ryood/ArEG/2nd Unit/PXL_20220523_073205050.jpg

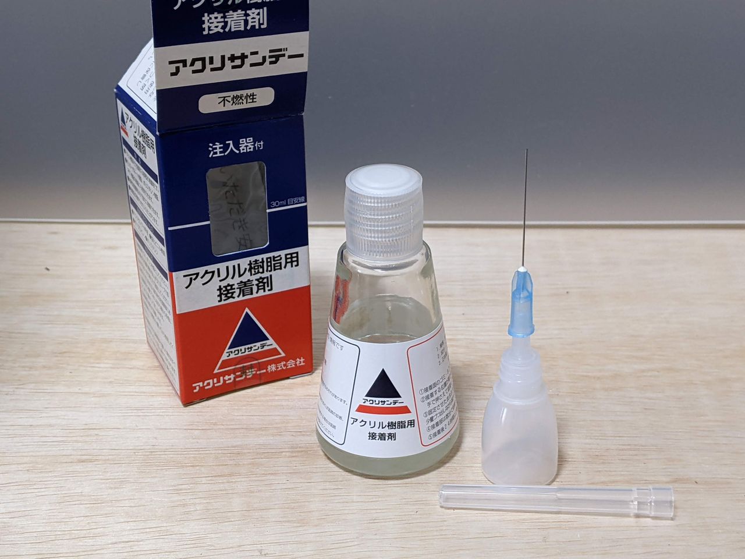
2nd Unit/PXL_20220523_073205050.jpg
