ryood/ArEG/2nd Unit/PXL_20220523_032654359.jpg

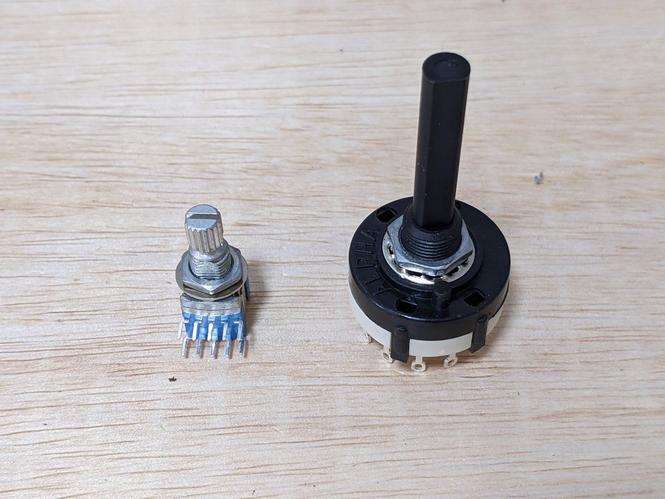
2nd Unit/PXL_20220523_032654359.jpg
