ryood/ArEG/2nd Unit/20220430_043404.png

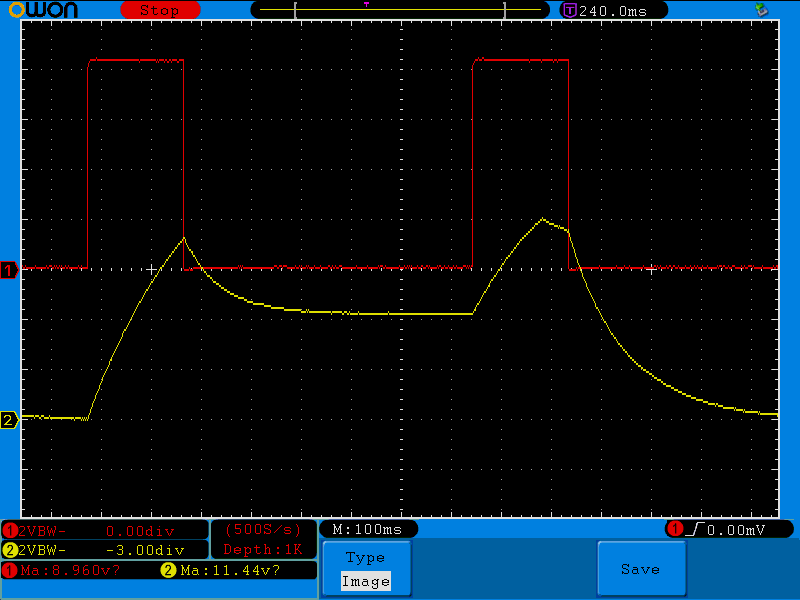
2nd Unit/20220430_043404.png
