ryood/ArEG/2nd Unit/20220502_182553.png

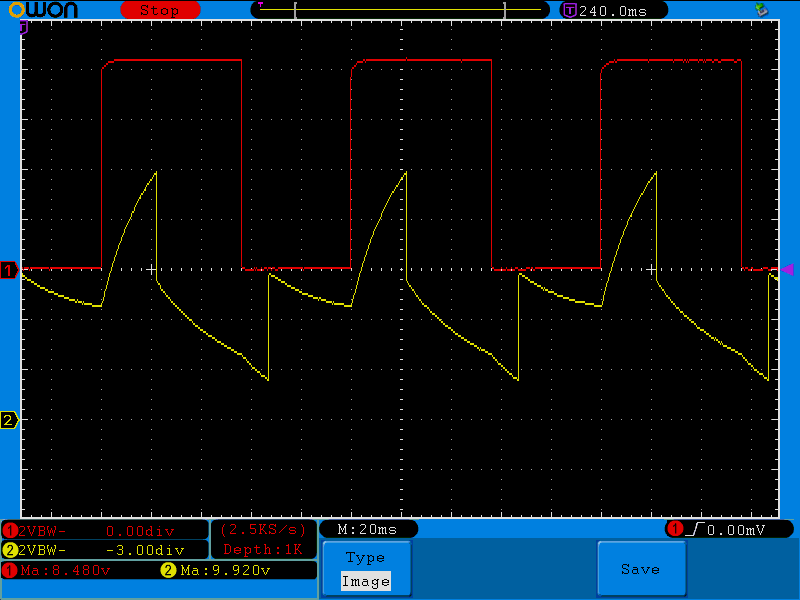
2nd Unit/20220502_182553.png
