ryood/ArEG/2nd Unit/PXL_20220523_032018060.jpg

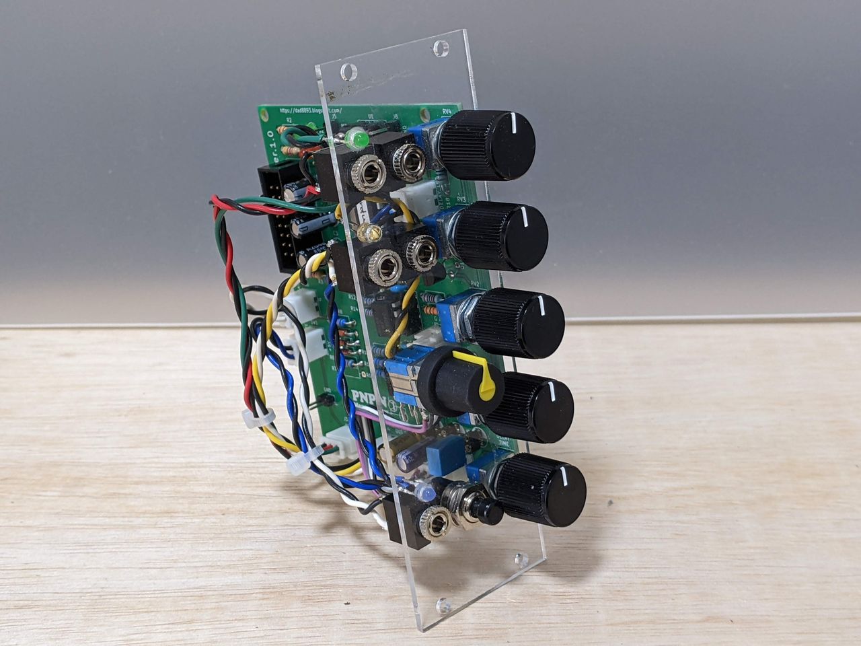
2nd Unit/PXL_20220523_032018060.jpg
