ryood/ArEG/KiCAD/ArEG_Brd3D.png

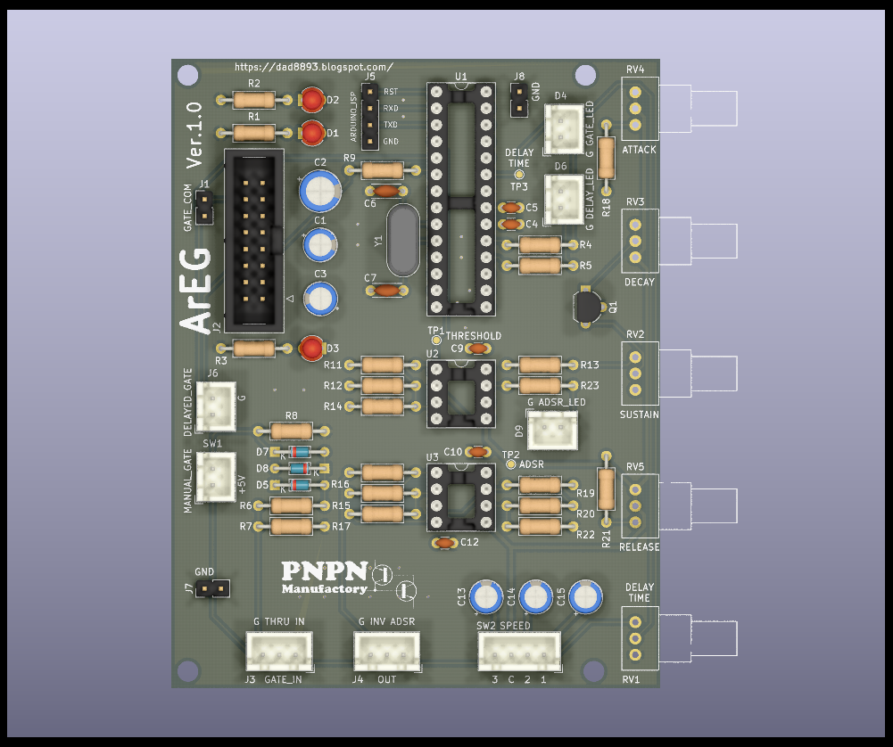
KiCAD/ArEG_Brd3D.png
