ryood/ArEG/KiCAD/ArEG_Brd3D_0.png

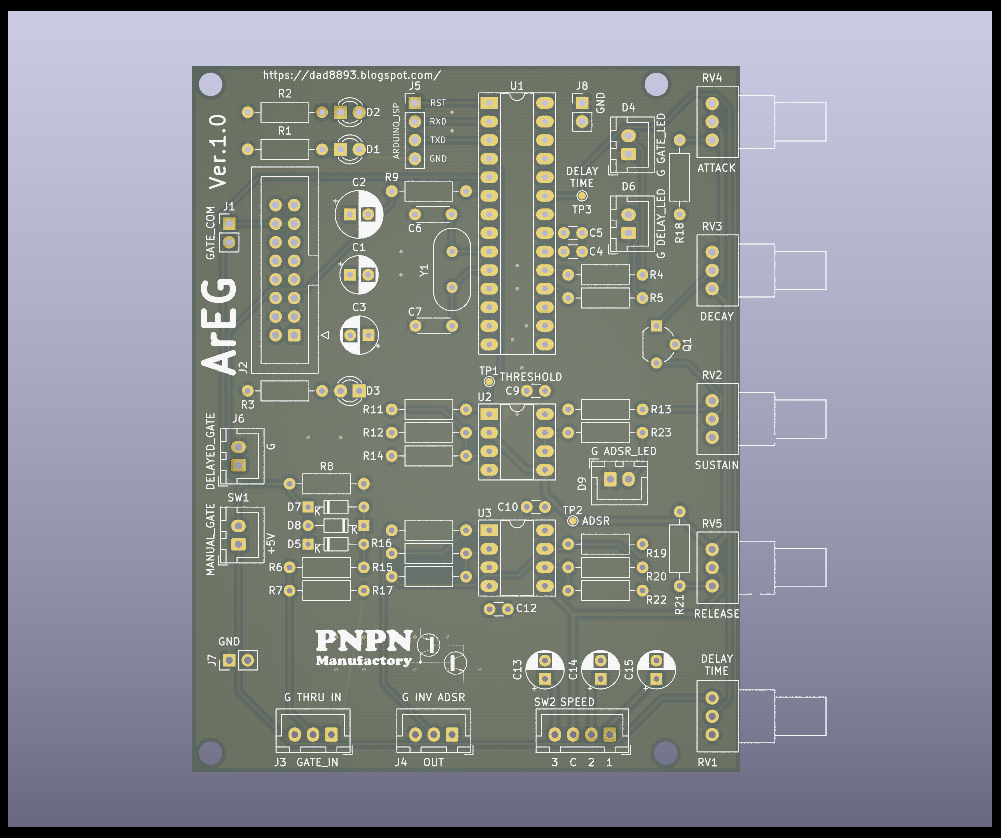
KiCAD/ArEG_Brd3D_0.png
