ryood/ArEG/KiCAD/ArEG_sch.png

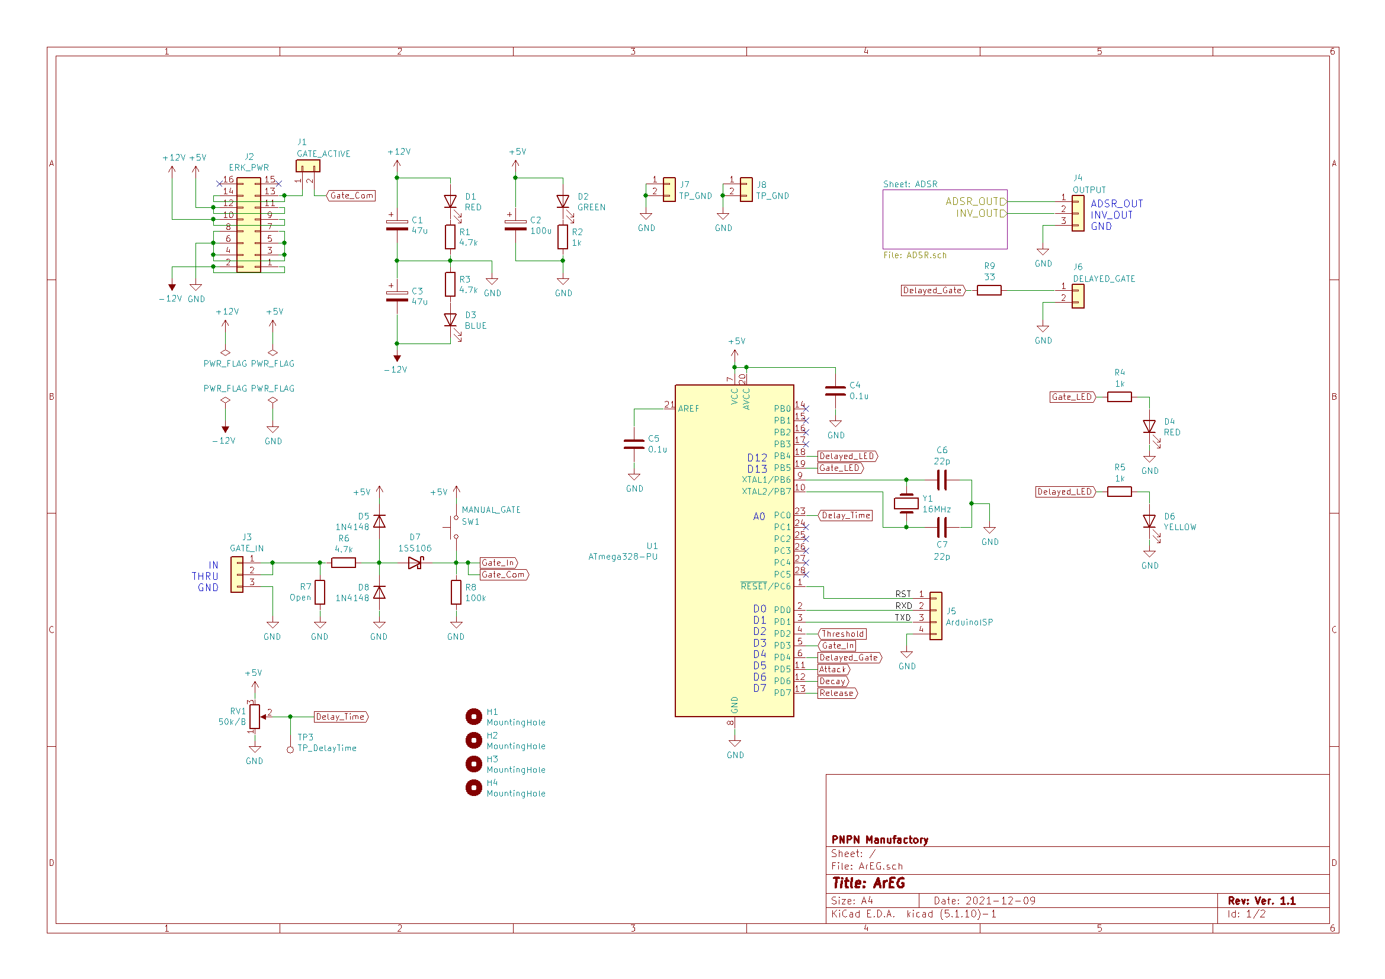
KiCAD/ArEG_sch.png
