ryood/ArEG/KiCAD/ArEG_sch_02.png

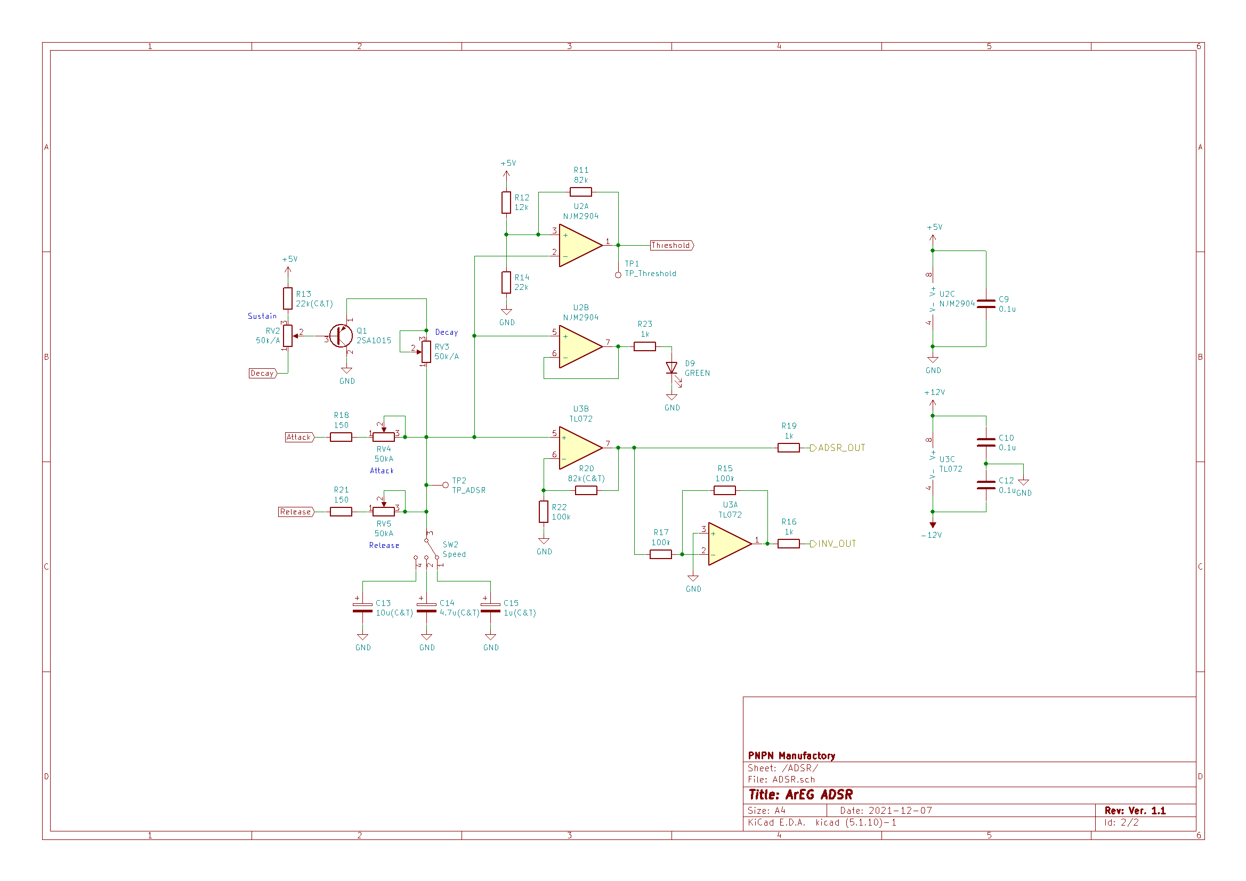
KiCAD/ArEG_sch_02.png
