ryood/ArEG/spice/ADSR+Inv_Hys_Comparetor_sim.png

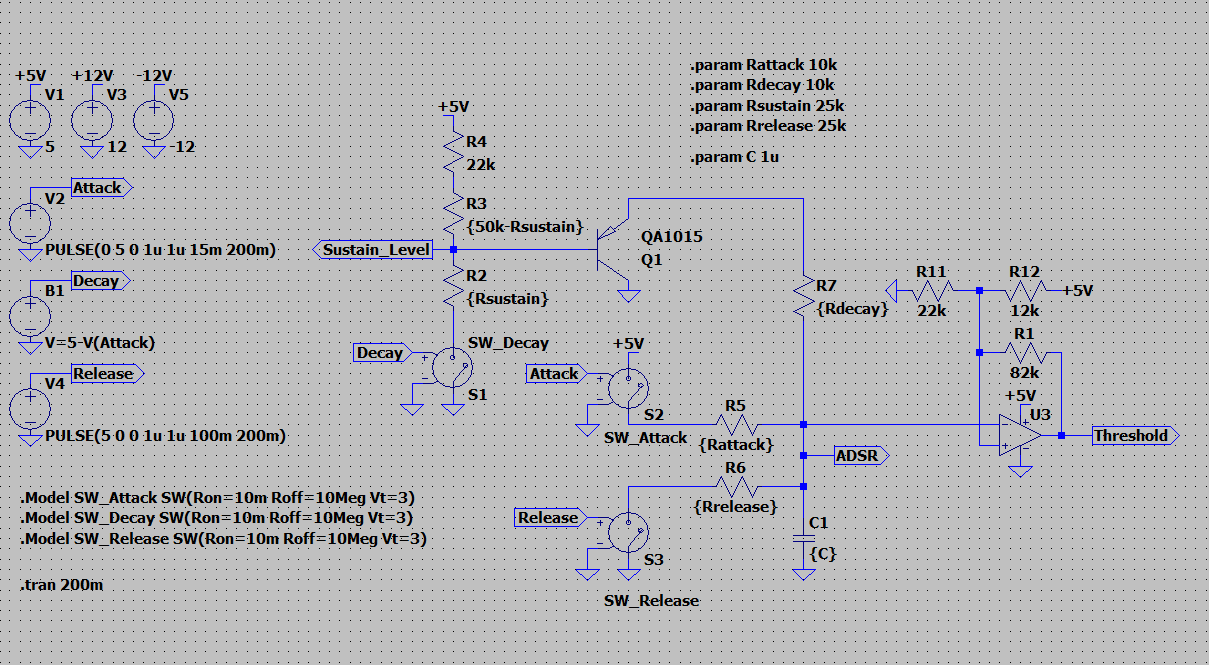
spice/ADSR+Inv_Hys_Comparetor_sim.png
