ryood/ArEG/spice/ADSR+Inv_Hys_Comparetor_tran.png

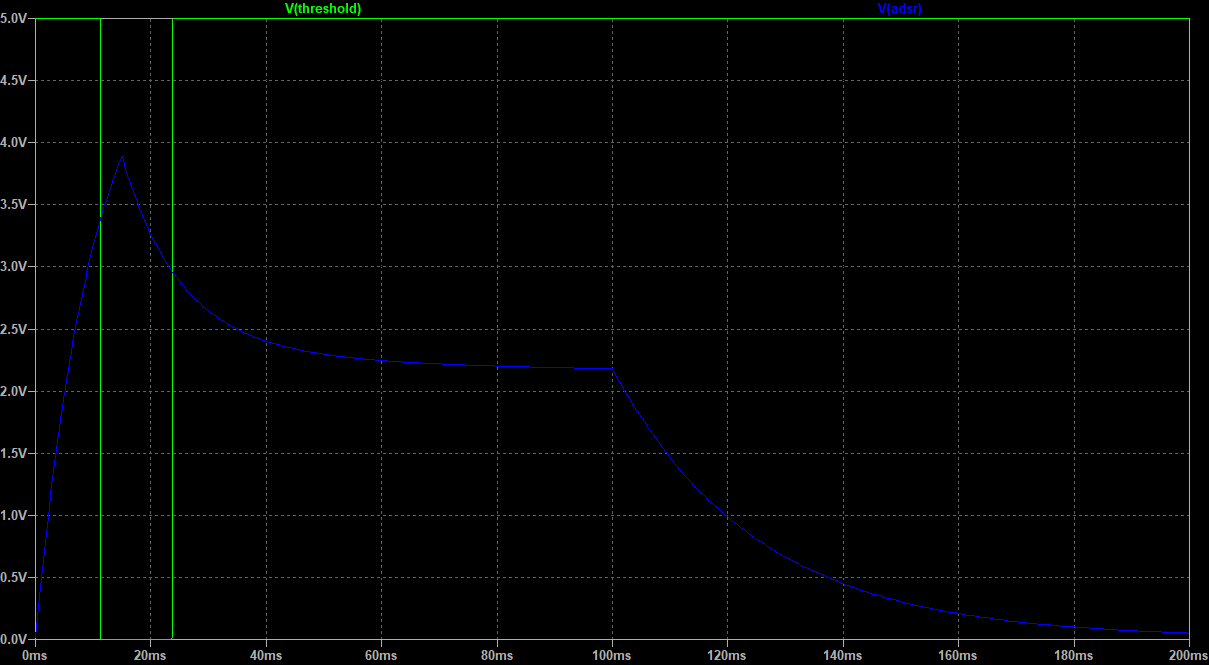
spice/ADSR+Inv_Hys_Comparetor_tran.png
