ryood/ArEG/spice/ADSR+NonInv_Hys_Comparetor_sim.png

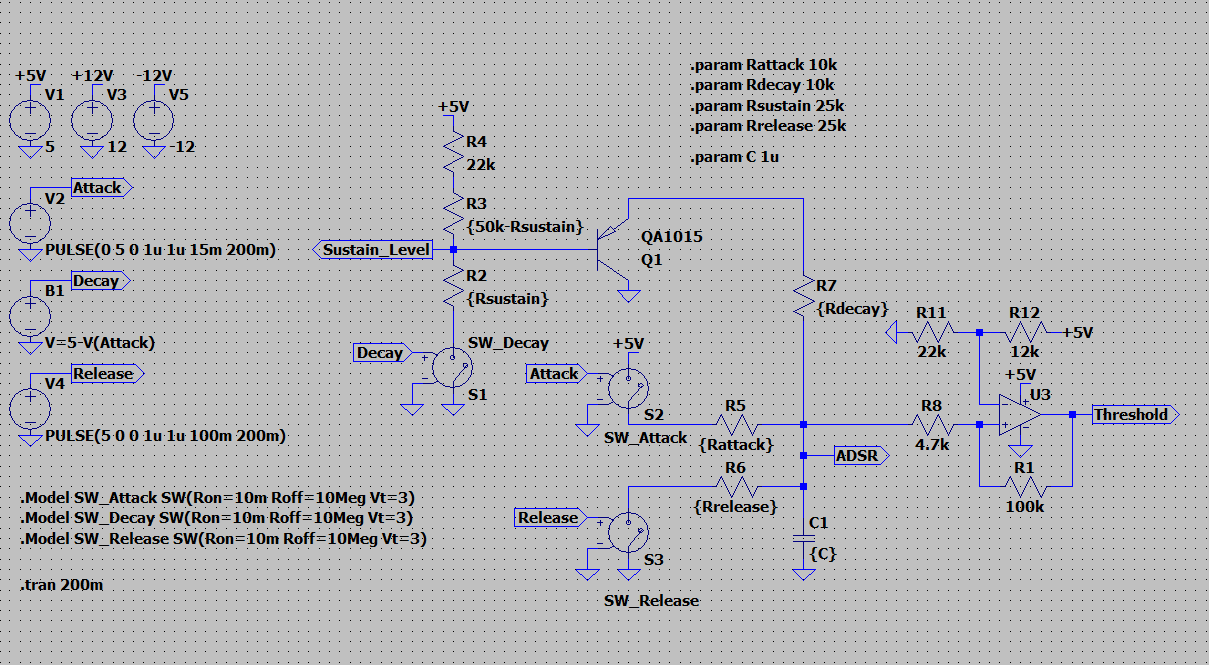
spice/ADSR+NonInv_Hys_Comparetor_sim.png
