ryood/ArEG/spice/Hys_Inv_Comarator_sim.PNG

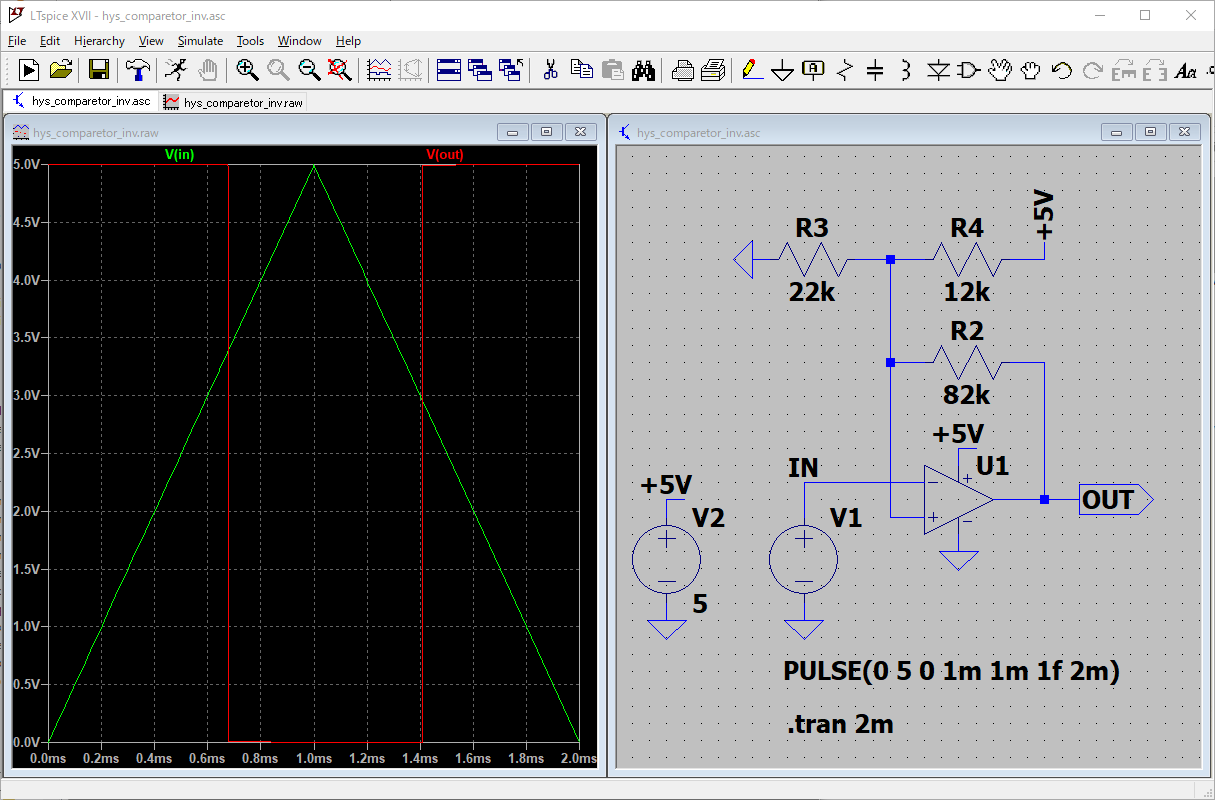
spice/Hys_Inv_Comarator_sim.PNG
