ryood/ArEG/spice/Hys_NonInv_Comarator_sim.PNG

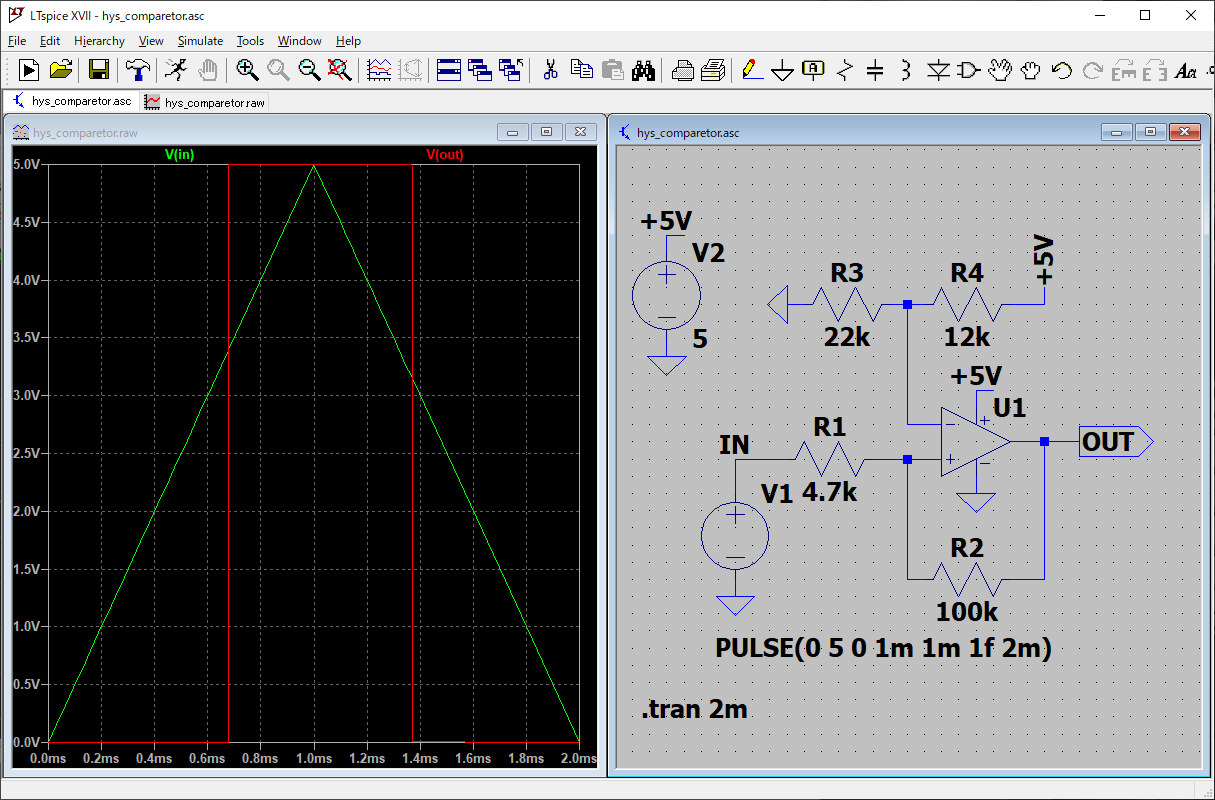
spice/Hys_NonInv_Comarator_sim.PNG
