ryood/ArEG/(list of files, cad)

Other CAD files:
CAD/ArEG_Panel_Ver.1.2.dwg
CAD/ArEG_Panel_Ver.1.1.dwg
CAD/ArEG_Panel.dwg
