ryood/ArEG/fritzing/ADSR_SW_Comparator_Hys_Inv_Test_ブレッドボード.png

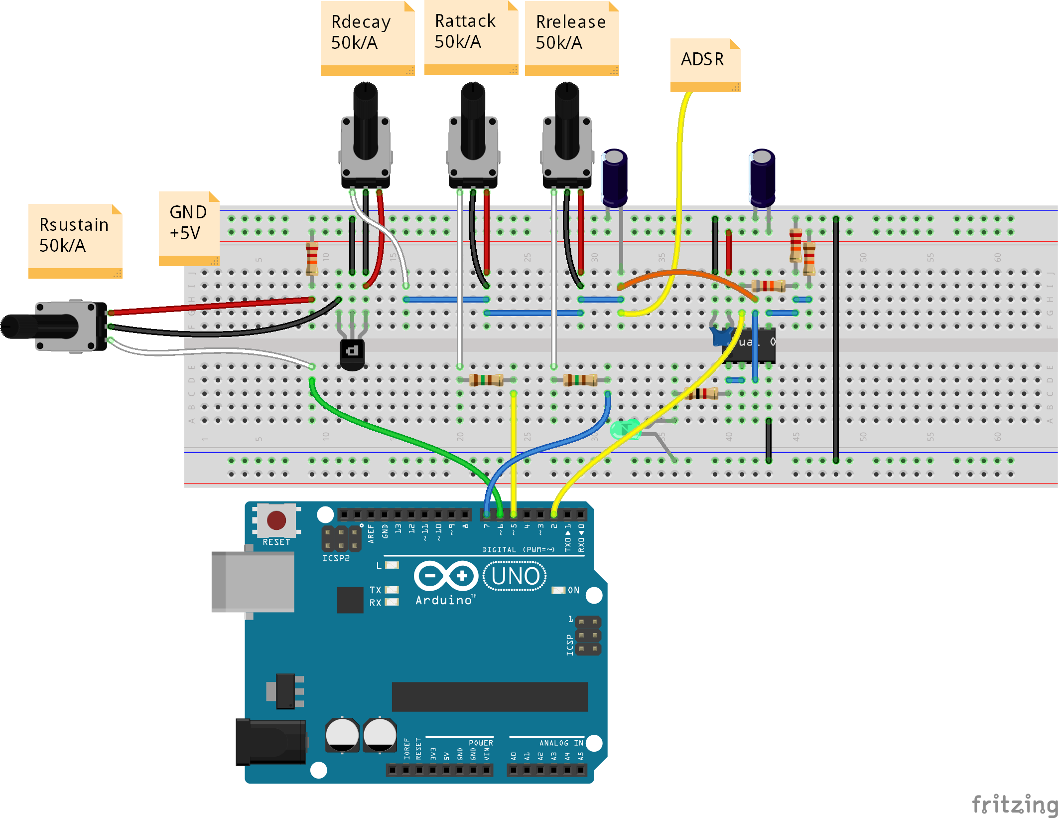
fritzing/ADSR_SW_Comparator_Hys_Inv_Test_ブレッドボード.png
