ryood/ArEG/spice/12V_Div_1V.asc

R1: res; 8k
R2: res; 1k
R3: res; 1k
R4: res; 1k
R5: res; 1k
V1: voltage; 12
Named nets: 0, V1, V2, V3, V4
.op
