ryood/ArEG/spice/hys_comparetor.asc

R1: res; 4.7k
R2: res; 100k
R3: res; 22k
R4: res; 12k
U1: UniversalOpamp2
V1: voltage; PULSE(0 5 0 1m 1m 1f 2m)
V2: voltage; 5
Named nets: +5V, 0, OUT, IN
.tran 2m
