ryood/ArEG/spice/ADSR+AMP.asc

B1: bv; V=5-V(Attack)
C1: cap; {C}
D1: schottky; BAT54
D2: schottky; BAT54
D3: LED
M1: nmos; 2N7002
Q1: pnp; QA1015
R1: res; 1Meg
R2: res; {Rsustain}
R3: res; {50k-Rsustain}
R4: res; 22k
R5: res; {Rattack}
R6: res; {Rrelease}
R7: res; {Rdecay}
R8: res; 120k
R9: res; 470k
R10: res; {Rbias}
R11: res; {100k-Rbias}
R12: res; 8.2k
R13: res; 220k
R14: res; 100k
R15: res; 100k
R16: res; 1k
R17: res; 1k
R18: res; 1k
U1: UniversalOpamp2
U2: UniversalOpamp2
U3: UniversalOpamp2
U4: UniversalOpamp2
V1: voltage; 5
V2: voltage; PULSE(0 5 0 1u 1u 20m 200m)
V3: voltage; 12
V4: voltage; PULSE(0 5 0 1u 1u 100m 200m)
V5: voltage; -12
Named nets: Decay, +5V, 0, Attack, Release, ADSR, Sustain_Level, +12V, -12V, INV_OUT, OUT
.param Rattack 10k
.param Rdecay 10k
.param Rsustain 25k
.param Rrelease 10k
.tran 500m
.param C 1u
.param Rbias 40k
