ryood/ArEG/spice/ADSR.asc

B1: bv; V=5-V(Attack)
C1: cap; {C}
D1: schottky; BAT54
D2: schottky; BAT54
M1: nmos; 2N7002
Q1: pnp; QA1015
R1: res; 1Meg
R2: res; {Rsustain}
R3: res; {50k-Rsustain}
R4: res; 22k
R5: res; {Rattack}
R6: res; {Rrelease}
R7: res; {Rdecay}
V1: voltage; 5
V2: voltage; PULSE(0 5 0 1u 1u 20m 200m)
V4: voltage; PULSE(0 5 0 1u 1u 100m 200m)
Named nets: Decay, +5V, 0, Attack, Release, ADSR, Sustain_Level
.param Rattack 10k
.param Rdecay 10k
.param Rsustain 25k
.param Rrelease 10k
.tran 500m
.param C 1u
