ryood/ArEG/spice/ADSR_SW+AMP+Comparator.asc

B1: bv; V=5-V(Attack)
C1: cap; {C}
D1: LED; LUW-W5AP
Q1: pnp; QA1015
R1: res; 100k
R2: res; {Rsustain}
R3: res; {50k-Rsustain}
R4: res; 22k
R5: res; {Rattack}
R6: res; {Rrelease}
R7: res; {Rdecay}
R8: res; 68k
R9: res; 100k
R10: res; 100k
R11: res; 20k
R12: res; 10k
R13: res; 1k
S1: sw; SW_Decay
S2: sw; SW_Attack
S3: sw; SW_Release
U1: UniversalOpamp2
U2: UniversalOpamp2
U3: UniversalOpamp2
U4: UniversalOpamp2
V1: voltage; 5
V2: voltage; PULSE(0 5 0 1u 1u 20m 200m)
V3: voltage; 12
V4: voltage; PULSE(5 0 0 1u 1u 100m 200m)
V5: voltage; -12
Named nets: Decay, +5V, 0, Attack, Release, Threshold, Sustain_Level, +12V, -12V, OUT, INV_OUT
.param Rattack 10k
.param Rdecay 10k
.param Rsustain 25k
.param Rrelease 25k
.tran 500m
.param C 1u
.Model SW_Attack SW(Ron=10m Roff=10Meg Vt=3)
.Model SW_Decay SW(Ron=10m Roff=10Meg Vt=3)
.Model SW_Release SW(Ron=10m Roff=10Meg Vt=3)
