ryood/ArEG/(list of files, drawings)

Other design files:
fritzing/ADSR_SW+AMP.+Comparator_Hys_Inv.fzz
fritzing/ADSR_SW+AMP.+Comparatorfzz.fzz
fritzing/ADSR_SW+AMP.+HysComparatorfzz.fzz
fritzing/ADSR_SW+AMP.fzz
fritzing/ADSR_SW.fzz
fritzing/ADSR_SW_Comparator_Hys_Inv_Test.fzz
fritzing/ADSR_SW_Comparator_Hys_NonInv_Test.fzz
fritzing/ADSR_SW_Test.fzz
fritzing/Gate_In_Limitter+Delay_Time_Test.fzz
fritzing/Gate_In_Limitter_Test.fzz
