ryood/ArEG/KiCAD/ArEG/ArEG.kicad_pcb

## KiCad design KiCAD/ArEG/ArEG.kicad_pcb (2022-01-23)

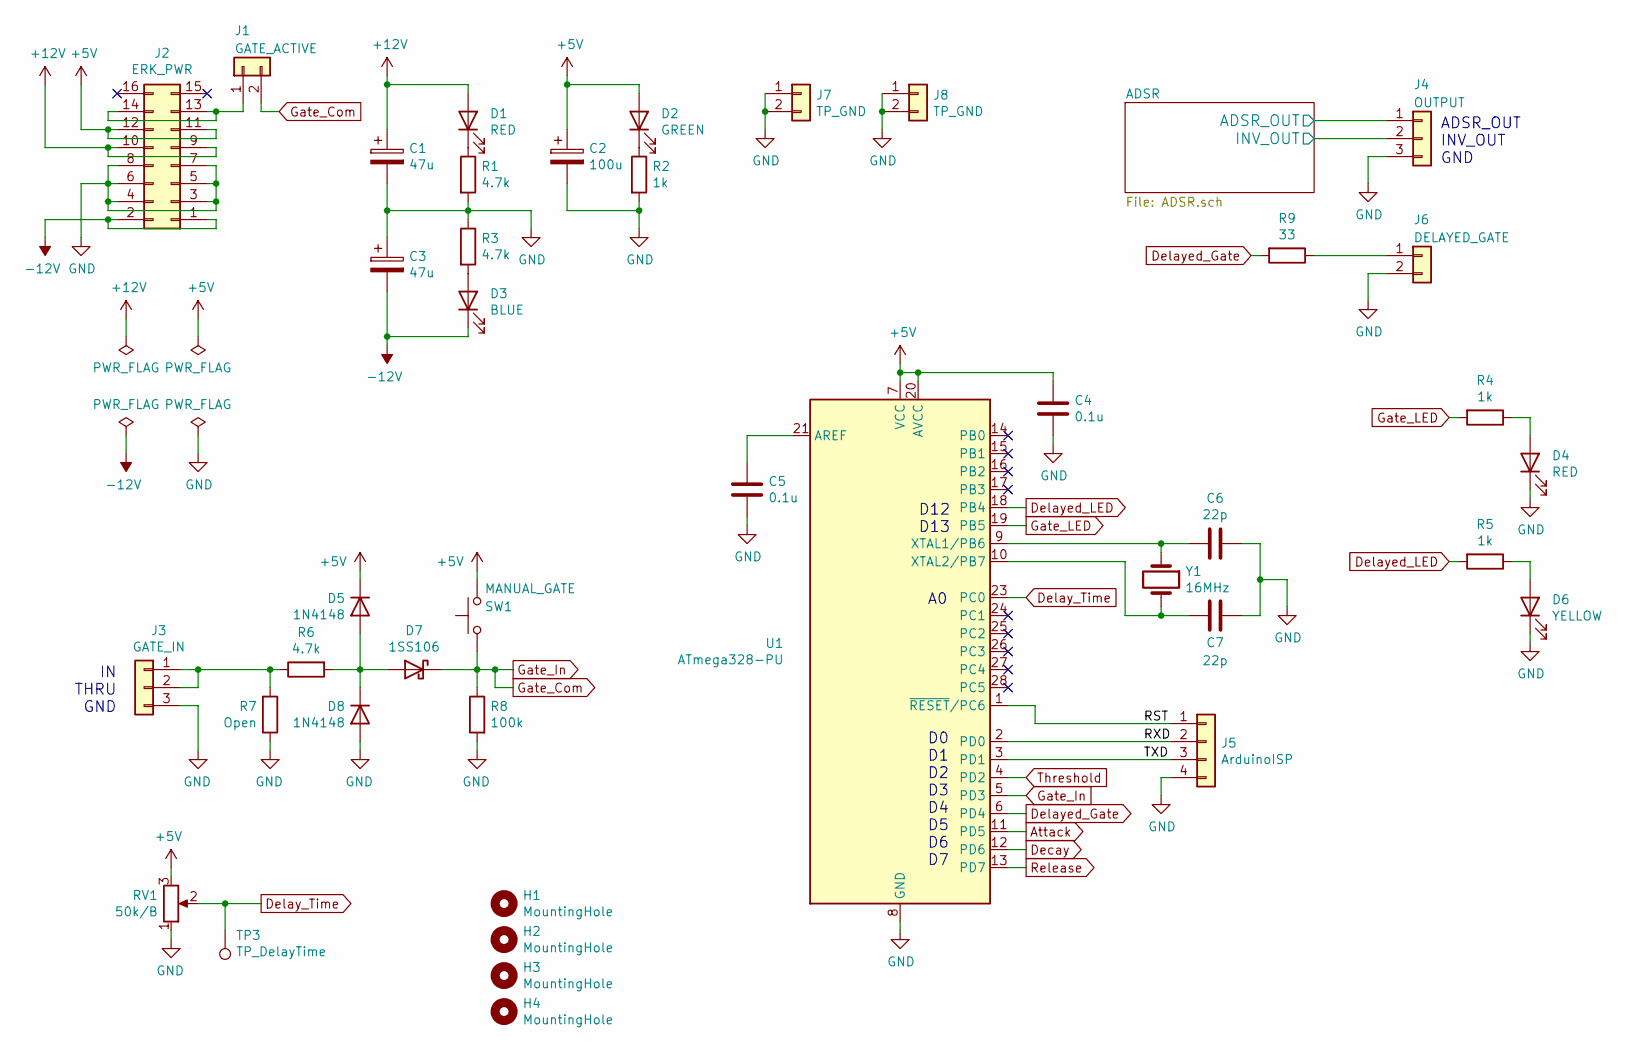
[picture p16: schematic ArEG.sch]

Parts:
C1, C3: 47u; CP_Radial_D5.0mm_P2.50mm
C2: 100u; CP_Radial_D6.3mm_P2.50mm
C4, C5: 0.1u; C_Disc_D3.0mm_W1.6mm_P2.50mm
C6, C7: 22p; C_Disc_D4.3mm_W1.9mm_P5.00mm
D1: RED; LED_D3.0mm
D2: GREEN; LED_D3.0mm
D3: BLUE; LED_D3.0mm
D4: RED; JST_XH_B2B-XH-A_1x02_P2.50mm_Vertical
D5, D8: 1N4148; D_DO-34_SOD68_P7.62mm_Horizontal
D6: YELLOW; JST_XH_B2B-XH-A_1x02_P2.50mm_Vertical
D7: 1SS106; D_DO-34_SOD68_P7.62mm_Horizontal
H1, H2, H3, H4: MountingHole; MountingHole_3.2mm_M3
J1: GATE_ACTIVE; PinHeader_1x02_P2.54mm_Vertical
J2: ERK_PWR; IDC-Header_2x08_P2.54mm_Vertical
J3: GATE_IN; JST_XH_B3B-XH-A_1x03_P2.50mm_Vertical
J4: OUTPUT; JST_XH_B3B-XH-A_1x03_P2.50mm_Vertical
J5: ArduinoISP; PinHeader_1x04_P2.54mm_Vertical
J6: DELAYED_GATE; JST_XH_B2B-XH-A_1x02_P2.50mm_Vertical
J7, J8: TP_GND; PinHeader_1x02_P2.54mm_Vertical
R1, R3, R6: 4.7k; R_Axial_DIN0207_L6.3mm_D2.5mm_P10.16mm_Horizontal
R2, R4, R5: 1k; R_Axial_DIN0207_L6.3mm_D2.5mm_P10.16mm_Horizontal
R7: Open; R_Axial_DIN0207_L6.3mm_D2.5mm_P10.16mm_Horizontal
R8: 100k; R_Axial_DIN0207_L6.3mm_D2.5mm_P10.16mm_Horizontal
R9: 33; R_Axial_DIN0207_L6.3mm_D2.5mm_P10.16mm_Horizontal
RV1: 50k/B; Potentiometer_Alps_RK09Y11_Single_Horizontal
SW1: MANUAL_GATE; JST_XH_B2B-XH-A_1x02_P2.50mm_Vertical
TP3: TP_DelayTime; TestPoint_Pad_D1.0mm
U1: ATmega328-PU; DIP-28_W7.62mm_Socket_LongPads
Y1: 16MHz; Crystal_HC18-U_Vertical

Connections:
+5V: C2.1, C4.2, D2.2 (A), D5.1 (K), J2.11, J2.12, RV1.3, SW1.1, U1.7 (VCC), U1.20 (AVCC); also elsewhere on the board
+12V: C1.1, D1.2 (A), J2.9, J2.10; also elsewhere on the board
-12V: C3.2, D3.1 (K), J2.1, J2.2; also elsewhere on the board
/ADSR/ADSR_OUT: J4.1; also elsewhere on the board
/ADSR/INV_OUT: J4.2; also elsewhere on the board
/RST: J5.1, U1.1 (~RESET~/PC6)
/RXD: J5.2, U1.2 (PD0)
/TXD: J5.3, U1.3 (PD1)
Attack: U1.11 (PD5); also elsewhere on the board
Decay: U1.12 (PD6); also elsewhere on the board
Delay_Time: RV1.2, TP3.1, U1.23 (PC0)
Delayed_Gate: R9.2, U1.6 (PD4)
Delayed_LED: R5.2, U1.18 (PB4)
GND: C1.2, C2.2, C3.1, C4.1, C5.1, C6.1, C7.2, D4.1 (K), D6.1 (K), D8.2 (A), J2.3, J2.4, J2.5, J2.6, J2.7, J2.8, J3.3, J4.3, J5.4, J6.2, J7.1, J7.2, J8.1, J8.2, R1.2, R2.2, R3.1, R7.1, R8.2, RV1.1, U1.8 (GND), U1.22 (GND); also elsewhere on the board
Gate_Com: D7.1 (K), J1.2, R8.1, SW1.2, U1.5 (PD3)
Gate_LED: R4.2, U1.19 (PB5)
unnamed: C5.2, U1.21 (AREF)
unnamed: C6.2, U1.9 (XTAL1/PB6), Y1.1
unnamed: C7.1, U1.10 (XTAL2/PB7), Y1.2
unnamed: D1.1 (K), R1.1
unnamed: D2.1 (K), R2.1
unnamed: D3.2 (A), R3.2
unnamed: D4.2 (A), R4.1
unnamed: D5.2 (A), D7.2 (A), D8.1 (K), R6.2
unnamed: D6.2 (A), R5.1
unnamed: J1.1, J2.13, J2.14
unnamed: J3.1, J3.2, R6.1, R7.2
unnamed: J6.1, R9.1
Release: U1.13 (PD7); also elsewhere on the board
Threshold: U1.4 (PD2); also elsewhere on the board

Notes on the sheet:
D0 D1 D2 D3 D4 D5 D6 D7
D12 D13
IN THRU GND
ADSR_OUT INV_OUT GND

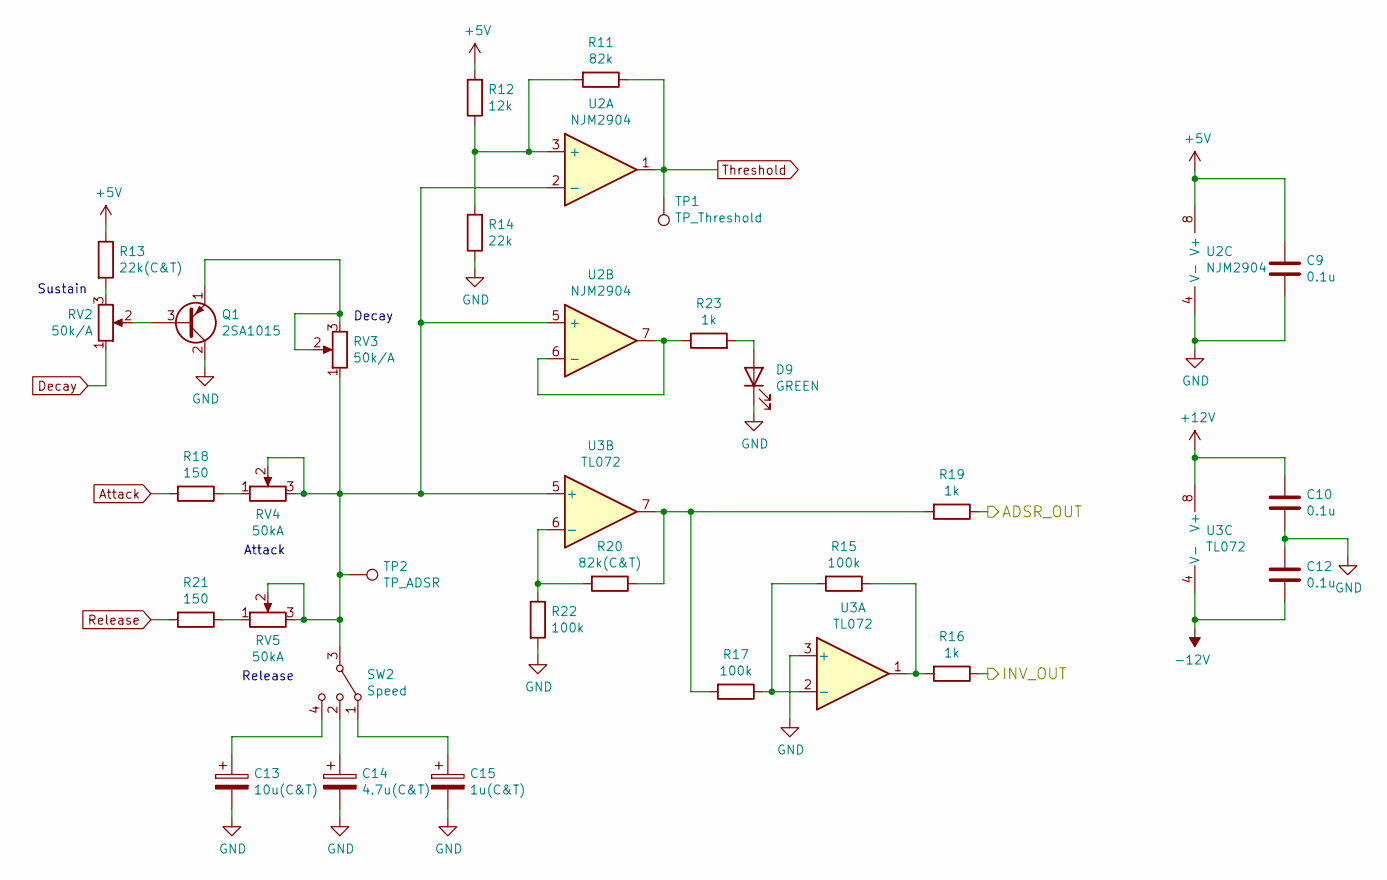
[picture p17: schematic ADSR.sch, ArEG ADSR]

Parts:
C9, C10, C12: 0.1u; C_Disc_D3.0mm_W1.6mm_P2.50mm
C13: 10u(C&T); CP_Radial_D5.0mm_P2.50mm
C14: 4.7u(C&T); CP_Radial_D5.0mm_P2.50mm
C15: 1u(C&T); CP_Radial_D5.0mm_P2.50mm
D9: GREEN; JST_XH_B2B-XH-A_1x02_P2.50mm_Vertical
Q1: 2SA1015; TO-92_Wide
R11: 82k; R_Axial_DIN0207_L6.3mm_D2.5mm_P10.16mm_Horizontal
R12: 12k; R_Axial_DIN0207_L6.3mm_D2.5mm_P10.16mm_Horizontal
R13: 22k(C&T); R_Axial_DIN0207_L6.3mm_D2.5mm_P10.16mm_Horizontal
R14: 22k; R_Axial_DIN0207_L6.3mm_D2.5mm_P10.16mm_Horizontal
R15, R17, R22: 100k; R_Axial_DIN0207_L6.3mm_D2.5mm_P10.16mm_Horizontal
R16, R19, R23: 1k; R_Axial_DIN0207_L6.3mm_D2.5mm_P10.16mm_Horizontal
R18, R21: 150; R_Axial_DIN0207_L6.3mm_D2.5mm_P10.16mm_Horizontal
R20: 82k(C&T); R_Axial_DIN0207_L6.3mm_D2.5mm_P10.16mm_Horizontal
RV2, RV3: 50k/A; Potentiometer_Alps_RK09Y11_Single_Horizontal
RV4, RV5: 50kA; Potentiometer_Alps_RK09Y11_Single_Horizontal
SW2: Speed; JST_XH_B4B-XH-A_1x04_P2.50mm_Vertical
TP1: TP_Threshold; TestPoint_Pad_D1.0mm
TP2: TP_ADSR; TestPoint_Pad_D1.0mm
U2: NJM2904; DIP-8_W7.62mm_Socket_LongPads
U3: TL072; DIP-8_W7.62mm_Socket_LongPads

Connections:
+5V: C9.1, R12.2, R13.1, U2.8 (V+); also elsewhere on the board
+12V: C10.1, U3.8 (V+); also elsewhere on the board
-12V: C12.2, U3.4 (V-); also elsewhere on the board
/ADSR/ADSR_OUT: R19.1; also elsewhere on the board
/ADSR/INV_OUT: R16.1; also elsewhere on the board
Attack: R18.2; also elsewhere on the board
Decay: RV2.1; also elsewhere on the board
GND: C9.2, C10.2, C12.1, C13.2, C14.2, C15.2, D9.1 (K), Q1.2 (C), R14.1, R22.2, U2.4 (V-), U3.3 (+); also elsewhere on the board
unnamed: C13.1, SW2.4
unnamed: C14.1, SW2.2
unnamed: C15.1, SW2.1
unnamed: D9.2 (A), R23.2
unnamed: Q1.1 (E), RV3.2, RV3.3
unnamed: Q1.3 (B), RV2.2
unnamed: R11.2, R12.1, R14.2, U2.3 (+)
unnamed: R13.2, RV2.3
unnamed: R15.1, R16.2, U3.1
unnamed: R15.2, R17.1, U3.2 (-)
unnamed: R17.2, R19.2, R20.1, U3.7
unnamed: R18.1, RV4.1
unnamed: R20.2, R22.1, U3.6 (-)
unnamed: R21.1, RV5.1
unnamed: R23.1, U2.6 (-), U2.7
unnamed: RV3.1, RV4.2, RV4.3, RV5.2, RV5.3, SW2.3, TP2.1, U2.2 (-), U2.5 (+), U3.5 (+)
Release: R21.2; also elsewhere on the board
Threshold: R11.1, TP1.1, U2.1; also elsewhere on the board

Notes on the sheet:
Sustain
Attack
Release
Decay

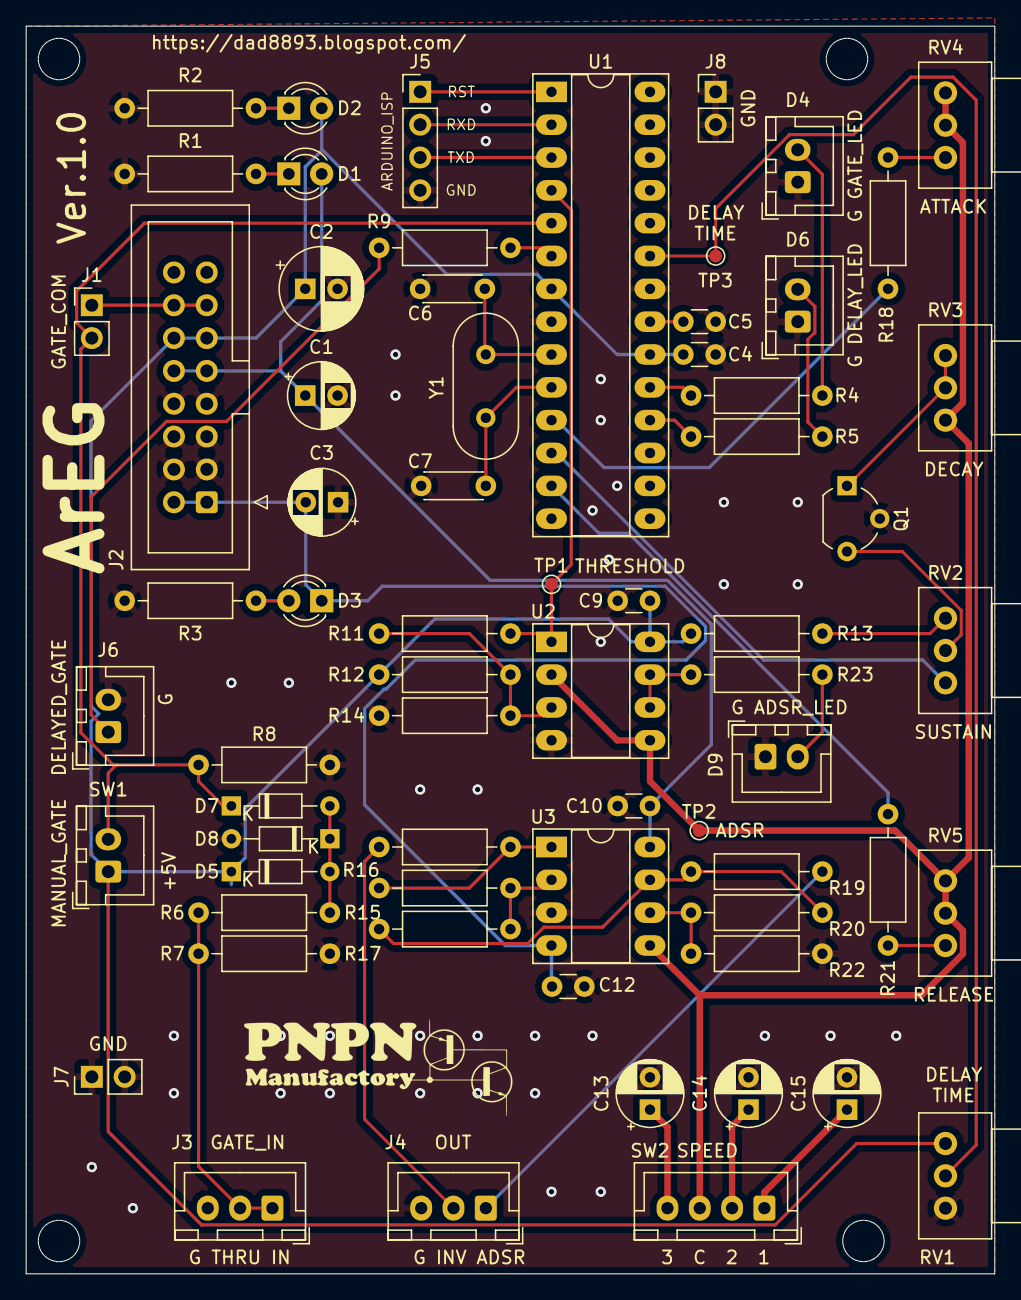
[picture p18: board ArEG.kicad_pcb from above]

Board: 2 copper layers, 74.9 x 96.5 mm, 71 parts (0 on the bottom side), 46 nets.
