ryood/ArEG/(commit log)

2021-12-07 入出力端子をまとめる前
    [ADSR.sch, ADSR_SW+AMP.fzz, ADSR_SW_Comparator_Hys_NonInv_Test.fzz, ArEG.kicad_pcb, ArEG.sch]
2022-01-23 Panel design
    [ADSR.sch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]
2022-05-13 Update schematics
    [ADSR.sch]
2022-05-13 New panel design
    [ArEG_Panel_Ver.1.1.dwg, ArEG_Panel_Ver.1.2.dwg]
